UniSA-Motorsport-Test1/BSPD/README.md

View this project on [CADLAB.io](https://cadlab.io/project/26523). 

# BSPD
