UniSA-Motorsport-Test1/BSPD/bom/BSPD_BOM_ICs.xlsx

Source: | D:\GrabCAD\BSPD\BSPD.kicad_sch
Date: | 2022-09-19 19:58
Tool: | Eeschema (6.0.5)
Generator: | D:\KiCad\6.0\bin\scripting\plugins/bom_csv_grouped_by_value.py
Component Count: | 66
Individual Components:
Collated Components: |  |  |  |  | In Stock Replacements
Item | Qty | Reference(s) | Value |  |  | LibPart | Footprint | Datasheet | Capacitance | Color | Constant Drain Current | Current Rating | E24 Values | Fixed Ouptut | Max Input | Power Rating | Rds | Resistance | Vds | Vgs | Voltage Rating | Vth
7 | 1 | J1 | Microfit_01x02_Vertical | Microfit_01x02_Vertical | ~ | UniSA_Motorsport_Connector:Microfit_01x02_Vertical | UniSA_Motorsport_Connector:Molex_Micro-Fit_43650-0215_1x02_Vertical | ~
8 | 1 | J2 | Conn_01x39_Male | Conn_01x39_Male | https://au.mouser.com/c/connectors/card-edge-connectors/standard-card-edge-connectors/?m=Samtec&series=MECF | Connector:Conn_01x39_Male | UniSA_Motorsport_Connector:Samtec_MECF-40-0_-L-DV_2x40_P1.27mm_Polarized_Edge | https://au.mouser.com/c/connectors/card-edge-connectors/standard-card-edge-connectors/?m=Samtec&series=MECF
9 | 1 | Q1 | DMN6075SQ-7 | SSM3K337R | https://au.mouser.com/ProductDetail/Toshiba/SSM3K337RLF?qs=lrCDz5EUXIbEa8mdLYjhPw%3D%3D | UniSA_Motorsport_Transistor:DMN6075SQ-7 | UniSA_Motorsport_SOT_TO:SOT-23-3 | https://www.diodes.com/assets/Datasheets/DMN6075SQ.pdf |  |  | 2A |  |  |  |  |  | 69mOhms |  | 60V | 20V |  | 3V
11 | 8 | RV1, RV2, RV3, RV4, RV5, RV6, RV7, RV8 | RT4656 | RT4656 | https://www.jaycar.com.au/100kohm-spectrol-25-turn-trimpot/p/RT4656 | Device:R_POT | Connector_PinHeader_2.54mm:PinHeader_1x03_P2.54mm_Vertical | https://www.jaycar.com.au/100kohm-spectrol-25-turn-trimpot/p/RT4656 |  |  |  |  |  |  |  |  |  | 100K
13 | 3 | U2, U5, U6 | LM7902D | LM2902D | https://au.mouser.com/ProductDetail/Texas-Instruments/LM2902D?qs=YEaxc5757jMxvpbZDuCExQ%3D%3D | BSPD-rescue:LM7902D-UniSA_Motorsport_OpAmp | UniSA_Motorsport_SO:SOIC-14 | https://www.ti.com/lit/ds/symlink/lm2902.pdf
14 | 1 | U3 | CD4081BM96 | MC14081BDG | https://au.mouser.com/ProductDetail/onsemi/MC14081BDG?qs=g2rIOKKlpoZOqtwrBduyQA%3D%3D | UniSA_Motorsport_Logic:CD4081BM96 | UniSA_Motorsport_SO:SOIC-14 | http://www.ti.com/lit/ds/symlink/cd4069ub.pdf?ts=1588337277788
15 | 1 | U4 | CD4071BM96 | CD4071BM96 | https://au.mouser.com/ProductDetail/Texas-Instruments/CD4071BM96?qs=HTr%252BoA4jRilOQsEJrENHWg%3D%3D | UniSA_Motorsport_Logic:CD4071BM96 | UniSA_Motorsport_SO:SOIC-14 | http://www.ti.com/lit/ds/symlink/cd4069ub.pdf?ts=1588337277788
16 | 1 | U7 | P783-Q24-S12-S | P783-Q24-S12-S | https://octopart.com/p783-q24-s12-s-cui-109470232?r=sp | UniSA_Motorsport_Others:P783-Q24-S12-S | UniSA_Motorsport_Others:P783-Q24-S12-S | https://octopart.com/p783-q24-s12-s-cui-109470232?r=sp
