UniSA-Motorsport-Test1/BSPD/bom/BSPD_BOM_Passive_Components.xlsx

Source: | D:\GrabCAD\BSPD\BSPD.kicad_sch
Date: | 2022-09-19 21:10
Tool: | Eeschema (6.0.5)
Generator: | D:\KiCad\6.0\bin\scripting\plugins/bom_csv_grouped_by_value.py
Component Count: | 66
Collated Components:
Item | Qty | Reference(s) | Value | LibPart | Footprint | Datasheet | Capacitance | Constant Drain Current | Current Rating | E24 Values | Fixed Ouptut | Max Input | Power Rating | Rds | Color | Resistance | Vds | Vgs | Voltage Rating | Vth
1 | 6 | C1, C2, C3, C4, C5, C6 | GCM0805_1u | UniSA_Motorsport_Capacitor:GCM0805_1u | UniSA_Motorsport_Capacitor:0805 | https://au.mouser.com/datasheet/2/281/murata_03122018_GCM_Series-1310150.pdf |  |  |  |  |  |  |  |  |  |  |  |  | 50V
2 | 1 | C7 | GCM0805_2.2u | UniSA_Motorsport_Capacitor:GCM0805_2.2u | UniSA_Motorsport_Capacitor:0805 | https://au.mouser.com/datasheet/2/281/murata_03122018_GCM_Series-1310150.pdf |  |  |  |  |  |  |  |  |  |  |  |  | 16V
3 | 1 | C8 | GCM1206_100u | UniSA_Motorsport_Capacitor:GCM1206_100u | UniSA_Motorsport_Capacitor:1206 | https://au.mouser.com/datasheet/2/281/murata_03122018_GCM_Series-1310150.pdf | 100uF |  |  |  |  |  |  |  |  |  |  |  | 50V
4 | 1 | C9 | GCM1206_22u | UniSA_Motorsport_Capacitor:GCM1206_22u | UniSA_Motorsport_Capacitor:1206 | https://au.mouser.com/datasheet/2/281/murata_03122018_GCM_Series-1310150.pdf | 22uF |  |  |  |  |  |  |  |  |  |  |  | 25V
5 | 10 | D1, D2, D3, D4, D5, D6 | LED_0805 | UniSA_Motorsport_Diode:LED_0805 | UniSA_Motorsport_Diode:0805 | https://au.mouser.com/datasheet/2/109/Dialight_CBI_data_599-0805_Apr2018-1370606.pdf |  |  |  |  |  |  |  |  | Red
5 | 10 | D7, D8, D9, D10 | LED_0805 | UniSA_Motorsport_Diode:LED_0805 | UniSA_Motorsport_Diode:0805 | https://au.mouser.com/datasheet/2/109/Dialight_CBI_data_599-0805_Apr2018-1370606.pdf |  |  |  |  |  |  |  |  | Green
10 | 3 | R1, R19, R21 | CRCW0805 | UniSA_Motorsport_Resistor:CRCW0805 | UniSA_Motorsport_Resistor:0805 | https://au.mouser.com/datasheet/2/427/dcrcwe3-1762152.pdf |  |  |  | http://www.ohmslawcalculator.com/e24-resistor-sizes |  |  | 125mW |  |  | 100K |  |  | 150V
10 | 8 |  | CRCW0806 | UniSA_Motorsport_Resistor:CRCW0806 | UniSA_Motorsport_Resistor:0806 | https://au.mouser.com/datasheet/2/427/dcrcwe3-1762152.pdf |  |  |  | http://www.ohmslawcalculator.com/e24-resistor-sizes |  |  | 125mW |  |  | 150R |  |  | 150V
10 | 6 |  | CRCW0807 | UniSA_Motorsport_Resistor:CRCW0807 | UniSA_Motorsport_Resistor:0807 | https://au.mouser.com/datasheet/2/427/dcrcwe3-1762152.pdf |  |  |  | http://www.ohmslawcalculator.com/e24-resistor-sizes |  |  | 125mW |  |  | 1K |  |  | 150V
10 | 4 |  | CRCW0808 | UniSA_Motorsport_Resistor:CRCW0808 | UniSA_Motorsport_Resistor:0808 | https://au.mouser.com/datasheet/2/427/dcrcwe3-1762152.pdf |  |  |  | http://www.ohmslawcalculator.com/e24-resistor-sizes |  |  | 125mW |  |  | 100R |  |  | 150V
10 | 3 |  | CRCW0809 | UniSA_Motorsport_Resistor:CRCW0809 | UniSA_Motorsport_Resistor:0809 | https://au.mouser.com/datasheet/2/427/dcrcwe3-1762152.pdf |  |  |  | http://www.ohmslawcalculator.com/e24-resistor-sizes |  |  | 125mW |  |  | 220K |  |  | 150V
10 | 1 |  | CRCW0810 | UniSA_Motorsport_Resistor:CRCW0810 | UniSA_Motorsport_Resistor:0810 | https://au.mouser.com/datasheet/2/427/dcrcwe3-1762152.pdf |  |  |  | http://www.ohmslawcalculator.com/e24-resistor-sizes |  |  | 125mW |  |  | 1.5K |  |  | 150V
