UniSA-Motorsport-Test1/BSPD/BSPD.kicad_pcb

## KiCad design BSPD.kicad_pcb (2023-03-02)

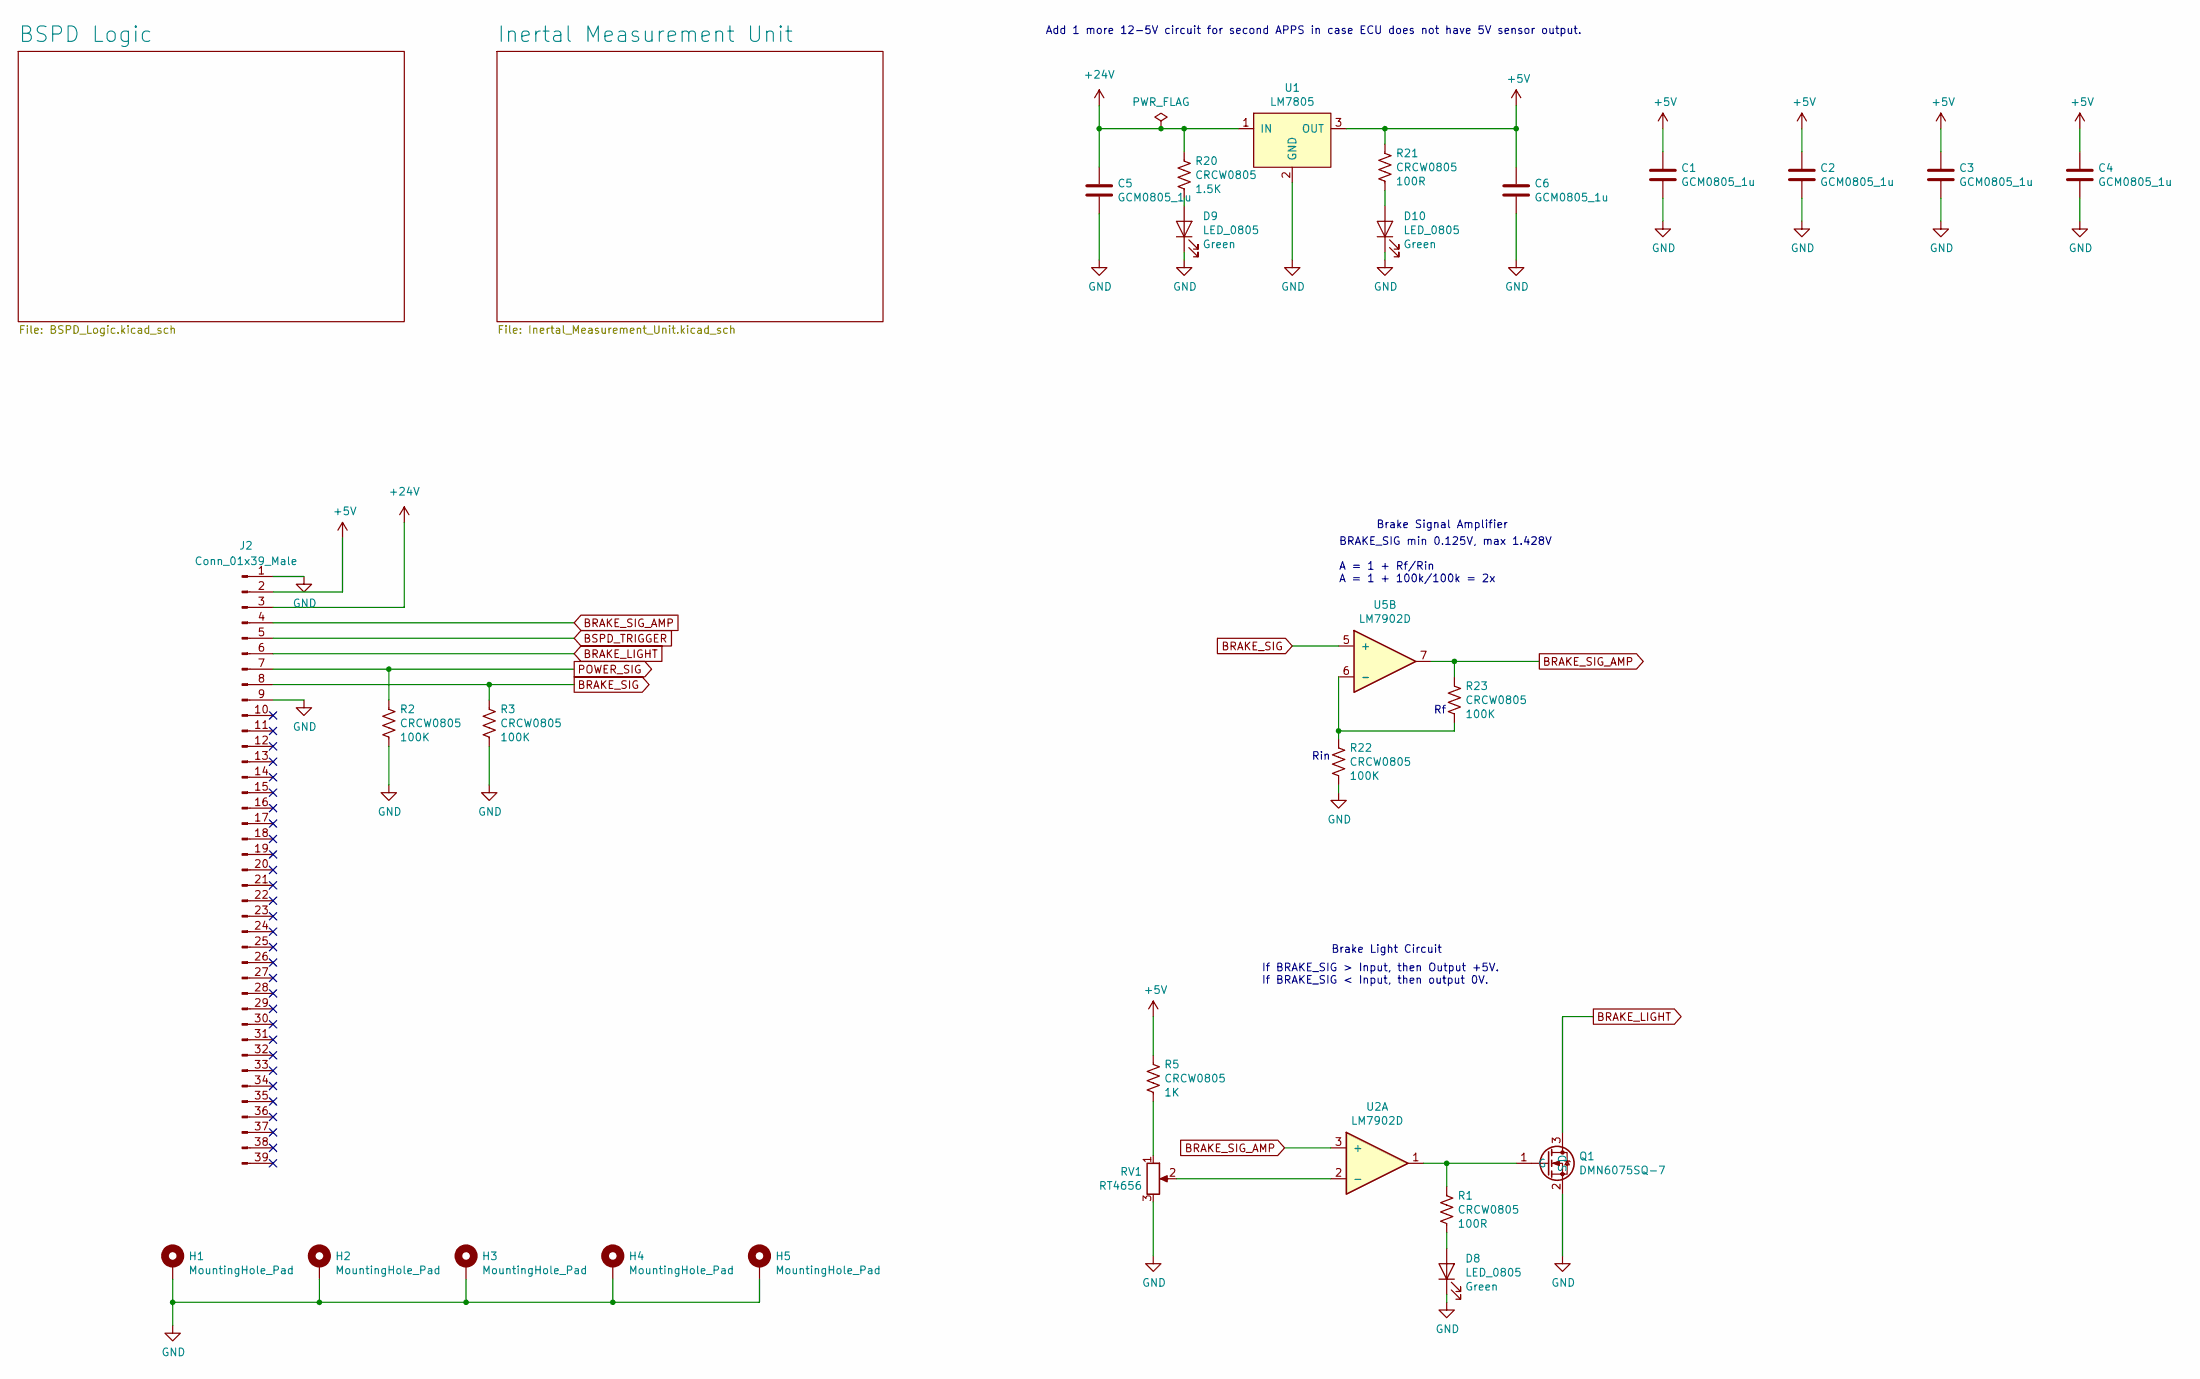
[picture p4: schematic BSPD.kicad_sch]

Parts:
C1, C2, C3, C4, C5, C6: GCM0805_1u; 0805; Voltage Rating 50V
D8, D9, D10: LED_0805; 0805
H1, H2, H3, H4, H5: MountingHole_Pad; MountingHole_3.2mm_M3_Pad_Via
J2: Conn_01x39_Male; Samtec_MECF-40-0_-L-DV_2x40_P1.27mm_Polarized_Edge
Q1: DMN6075SQ-7; SOT-23-3
R1, R2, R3, R5, R20, R21, R22, R23: CRCW0805; 0805; Voltage Rating 150V; Power Rating 125mW
RV1: RT4656; PinHeader_1x03_P2.54mm_Vertical
U1: LM7805; SOT-223-4; Current Rating 1.5A
U2, U5: LM7902D; SOIC-14

Connections:
+5V: C1.1, C2.1, C3.1, C4.1, C6.1, J2.2, R5.1, R21.1, U1.3 (OUT); also elsewhere on the board
+24V: C5.1, J2.3, R20.1, U1.1 (IN); also elsewhere on the board
BRAKE_LIGHT: J2.6, Q1.3 (D)
BRAKE_SIG: J2.8, R3.1, U5.5 (+)
BRAKE_SIG_AMP: J2.4, R23.1, U2.3 (+), U5.7; also elsewhere on the board
BSPD_TRIGGER: J2.5; also elsewhere on the board
GND: C1.2, C2.2, C3.2, C4.2, C5.2, C6.2, D8.1 (K), D9.1 (K), D10.1 (K), H1.1, H2.1, H3.1, H4.1, H5.1, J2.1, J2.9, Q1.2 (S), R2.2, R3.2, R22.2, RV1.3, U1.2 (GND); also elsewhere on the board
unnamed: D8.2 (A), R1.2
unnamed: D9.2 (A), R20.2
unnamed: D10.2 (A), R21.2
unnamed: Q1.1 (G), R1.1, U2.1
unnamed: R5.2, RV1.1
unnamed: R22.1, R23.2, U5.6 (-)
unnamed: RV1.2, U2.2 (-)
POWER_SIG: J2.7, R2.1; also elsewhere on the board

Notes on the sheet:
Rin
Brake Signal Amplifier
Add 1 more 12-5V circuit for second APPS in case ECU does not have 5V sensor output.
Brake Light Circuit
BRAKE_SIG min 0.125V, max 1.428V A = 1 + Rf/Rin A = 1 + 100k/100k = 2x
If BRAKE_SIG > Input, then Output +5V. If BRAKE_SIG < Input, then output 0V.

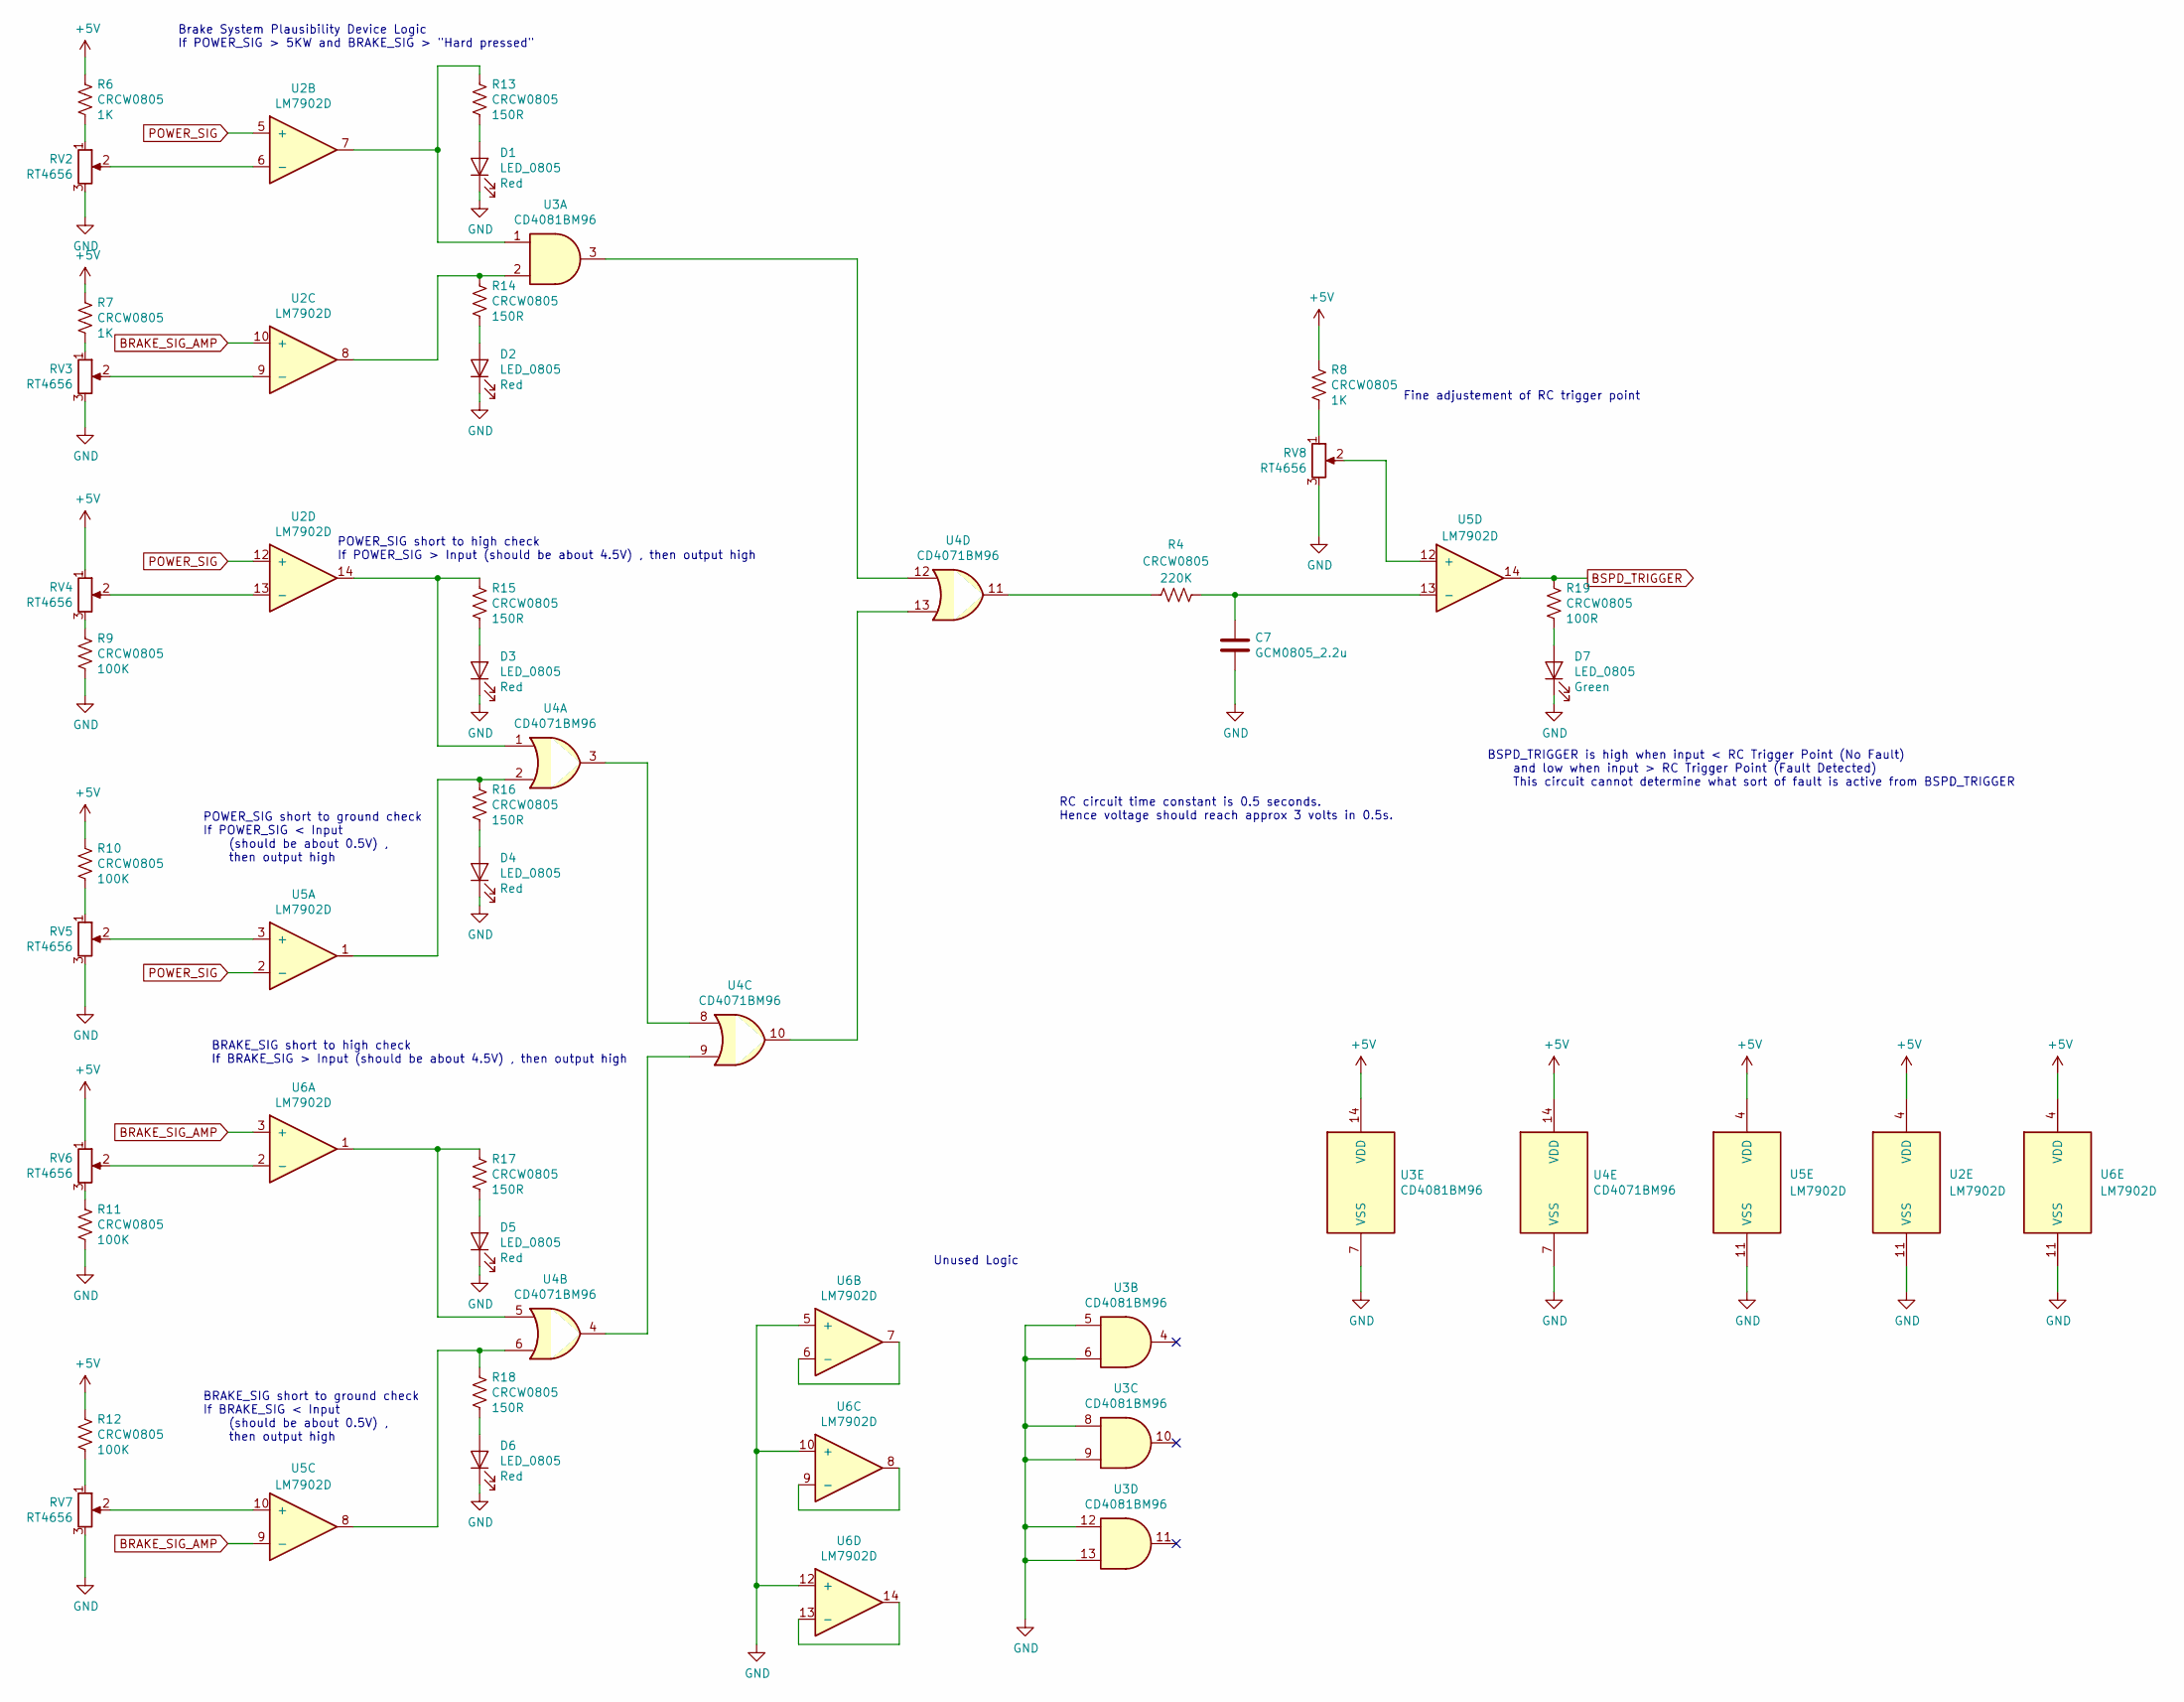
[picture p5: schematic BSPD_Logic.kicad_sch]

Parts:
C7: GCM0805_2.2u; 0805; Voltage Rating 16V
D1, D2, D3, D4, D5, D6, D7: LED_0805; 0805
R4, R6, R7, R8, R9, R10, R11, R12, R13, R14, R15, R16, R17, R18, R19: CRCW0805; 0805; Voltage Rating 150V; Power Rating 125mW
RV2, RV3, RV4, RV5, RV6, RV7, RV8: RT4656; PinHeader_1x03_P2.54mm_Vertical
U2, U5, U6: LM7902D; SOIC-14
U3: CD4081BM96; SOIC-14
U4: CD4071BM96; SOIC-14

Connections:
+5V: R6.1, R7.1, R8.1, R10.1, R12.1, RV4.1, RV6.1, U2.4 (VDD), U3.14 (VDD), U4.14 (VDD), U5.4 (VDD), U6.4 (VDD); also elsewhere on the board
BRAKE_SIG_AMP: U2.10 (+), U5.9 (-), U6.3 (+); also elsewhere on the board
BSPD_TRIGGER: R19.1, U5.14; also elsewhere on the board
GND: C7.2, D1.1 (K), D2.1 (K), D3.1 (K), D4.1 (K), D5.1 (K), D6.1 (K), D7.1 (K), R9.2, R11.2, RV2.3, RV3.3, RV5.3, RV7.3, RV8.3, U2.11 (VSS), U3.5, U3.6, U3.7 (VSS), U3.8, U3.9, U3.12, U3.13, U4.7 (VSS), U5.11 (VSS), U6.5 (+), U6.10 (+), U6.11 (VSS), U6.12 (+); also elsewhere on the board
unnamed: C7.1, R4.2, U5.13 (-)
unnamed: D1.2 (A), R13.2
unnamed: D2.2 (A), R14.2
unnamed: D3.2 (A), R15.2
unnamed: D4.2 (A), R16.2
unnamed: D5.2 (A), R17.2
unnamed: D6.2 (A), R18.2
unnamed: D7.2 (A), R19.2
unnamed: R4.1, U4.11
unnamed: R6.2, RV2.1
unnamed: R7.2, RV3.1
unnamed: R8.2, RV8.1
unnamed: R9.1, RV4.3
unnamed: R10.2, RV5.1
unnamed: R11.1, RV6.3
unnamed: R12.2, RV7.1
unnamed: R13.1, U2.7, U3.1
unnamed: R14.1, U2.8, U3.2
unnamed: R15.1, U2.14, U4.1
unnamed: R16.1, U4.2, U5.1
unnamed: R17.1, U4.5, U6.1
unnamed: R18.1, U4.6, U5.8
unnamed: RV2.2, U2.6 (-)
unnamed: RV3.2, U2.9 (-)
unnamed: RV4.2, U2.13 (-)
unnamed: RV5.2, U5.3 (+)
unnamed: RV6.2, U6.2 (-)
unnamed: RV7.2, U5.10 (+)
unnamed: RV8.2, U5.12 (+)
unnamed: U3.3, U4.12
unnamed: U4.3, U4.8
unnamed: U4.4, U4.9
unnamed: U4.10, U4.13
unnamed: U6.6 (-), U6.7
unnamed: U6.8, U6.9 (-)
unnamed: U6.13 (-), U6.14
POWER_SIG: U2.5 (+), U2.12 (+), U5.2 (-); also elsewhere on the board

Notes on the sheet:
POWER_SIG short to high check If POWER_SIG > Input (should be about 4.5V) , then output high
POWER_SIG short to ground check If POWER_SIG < Input (should be about 0.5V) , then output high
Fine adjustement of RC trigger point
BRAKE_SIG short to ground check If BRAKE_SIG < Input (should be about 0.5V) , then output high
RC circuit time constant is 0.5 seconds. Hence voltage should reach approx 3 volts in 0.5s.
Brake System Plausibility Device Logic If POWER_SIG > 5KW and BRAKE_SIG > "Hard pressed"
BSPD_TRIGGER is high when input < RC Trigger Point (No Fault) and low when input > RC Trigger Point (Fault Detected) This circuit cannot determine what sort of fault is active from BSPD_TRIGGER
BRAKE_SIG short to high check If BRAKE_SIG > Input (should be about 4.5V) , then output high
Unused Logic

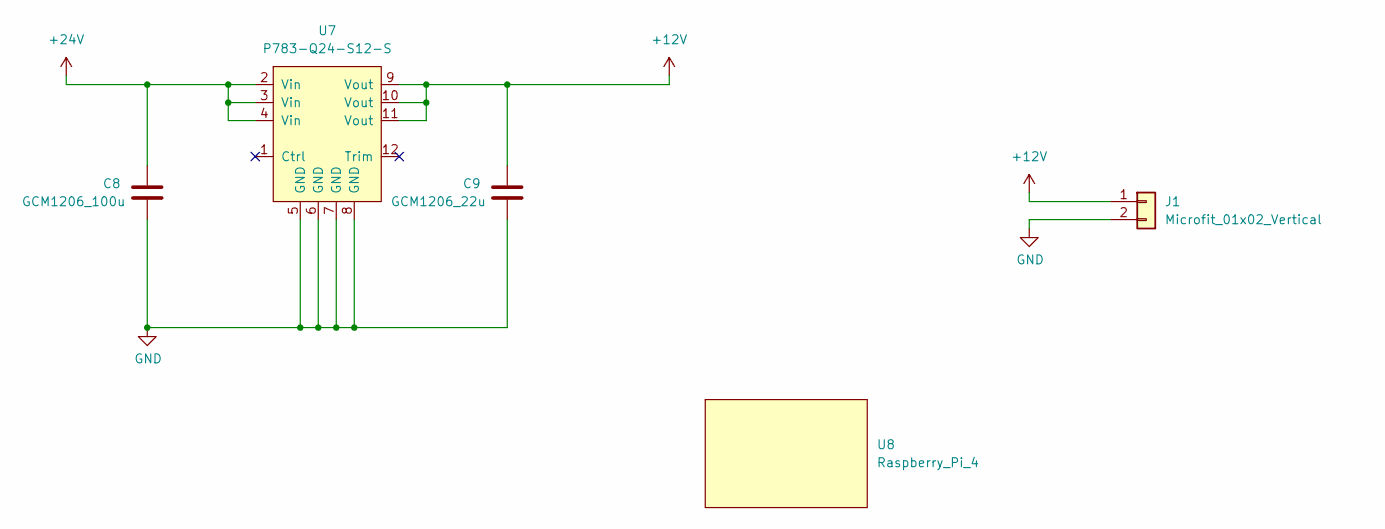
[picture p6: schematic Inertal_Measurement_Unit.kicad_sch]

Parts:
C8: GCM1206_100u; CP_Radial_D10.0mm_P5.00mm; Voltage Rating 50V
C9: GCM1206_22u; 1206; Voltage Rating 25V
J1: Microfit_01x02_Vertical; Molex_Micro-Fit_43650-0215_1x02_Vertical
U7: P783-Q24-S12-S
U8: Raspberry_Pi_4; Raspberry PI 4

Connections:
+12V: C9.1, J1.1, U7.9 (Vout), U7.10 (Vout), U7.11 (Vout)
+24V: C8.1, U7.2 (Vin), U7.3 (Vin), U7.4 (Vin); also elsewhere on the board
GND: C8.2, C9.2, J1.2, U7.5 (GND), U7.6 (GND), U7.7 (GND), U7.8 (GND); also elsewhere on the board

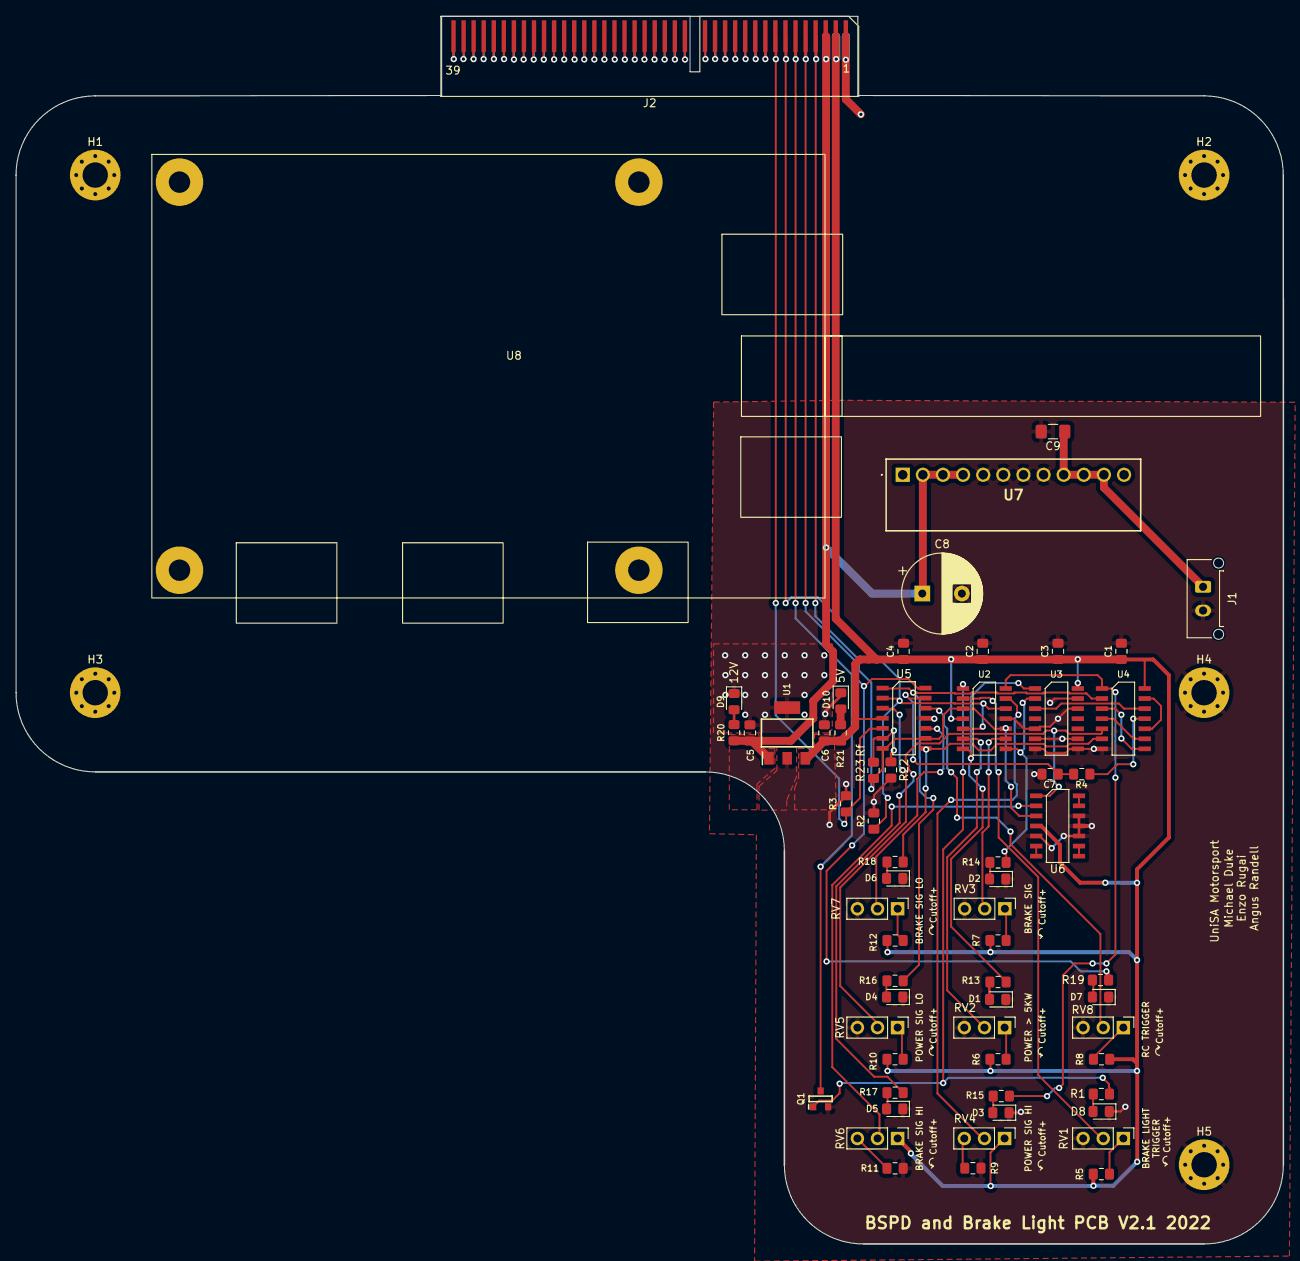
[picture p7: board BSPD.kicad_pcb from above]

Board: 2 copper layers, 160.0 x 155.0 mm, 66 parts (0 on the bottom side), 52 nets.
