UniSA-Motorsport-Test1/BSPD/(threads)

Thread 3 (2023-02-27):

[ISSUE] IMU Shorting Through Silkscreen

ranaj007, 2023-02-27:
**Describe The Issue**
When bolted down too tightly the Raspberry PI pins are able break through the silkscreen layer on the pcb and short to the ground plane. This results in the PI being unpowered with no LEDs lit up and the LEDs on the CAN shield rapidly flickering.

**To Reproduce**
1. Tighten the Raspberry PI mounts
2. Power GLV
3. If no LED flicker, try flicking the CAN shields power from PI to Off and then back to PI
4. If no flickering occurs and Raspberry PI LEDs are on then the power is not shorting

**Expected Behavior**
Raspberry PI LEDs are on and no flickering occurs on CAN shield's LEDs.

**Suggested Fix**
Remove grounding plane on pcb below the Raspberry PI as the plane being there is unnecessary.
See CADLAB.io for more details.
(https://cadlab.io/project/26523/Development/circuit/QlNQRC5raWNhZF9wY2I%3D)

Closed 2023-03-02.
