UniSA-Motorsport-Test1/BSPD/(commit log)

2023-02-16 Added BSPD Files
    [BSPD-B_Cu.gbl, BSPD-B_Mask.gbs, BSPD-B_SilkS.gbo, BSPD-B_Silkscreen.gbo, BSPD-Edge_Cuts.gm1, BSPD-F_Cu.gtl, BSPD-F_Mask.gts, BSPD-F_SilkS.gto]
2023-02-21 Switched D7 and R19 with D3 and R15
    [BSPD.kicad_pcb]
2023-02-21 made traces the correct width
    [BSPD.kicad_pcb]
2023-02-28 The ground rale has been modifed so now it is not where the rasberry pie will be mounted which should stop it from shorting to ground
    [BSPD.kicad_pcb]
